Pan-Robotics/DRV8243-LS7366R-Motion-Controller/README.md

# DRV8243-LS7366R-Motion-Controller
Motion Control PCB, integrating the DRV8243 motor driver and LS7366R encoder reader for feedback control of DC motors
