Pan-Robotics/DRV8243-LS7366R-Motion-Controller/DRV8243 - LS7366R DC Motion Controller/Docs/Photos/3D-Back.png

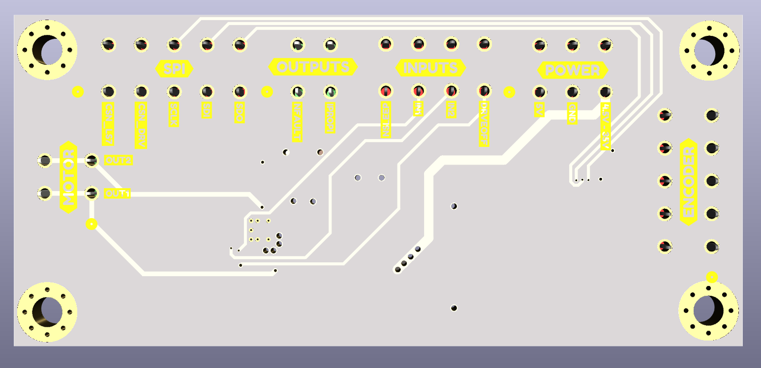
DRV8243 - LS7366R DC Motion Controller/Docs/Photos/3D-Back.png
