Pan-Robotics/DRV8243-LS7366R-Motion-Controller/DRV8243 - LS7366R DC Motion Controller/Docs/DRVLS7 Motion Controller PCB BOM.xls

BOM
Part | Value | Device | Package | Qty | Description | Remark
C1, C3 | 100nF | 1206B104K101CC | C_1206 | 2 | 0.1 µF ±10% 100V Ceramic Capacitor X7R 1206 (3216 Metric) | https://mm.digikey.com/Volume0/opasdata/d220001/medias/docus/5660/3372_1206B104K101CC.pdf
C2 | 100uF | 50TZV100M8X10.5 | C_Elec_8x10.5 | 1 | 100 µF 50 V Aluminum Electrolytic Capacitors Radial, Can - SMD 2000 Hrs @ 105°C | https://www.rubycon.co.jp/wp-content/uploads/catalog-aluminum/TZV.pdf
U1 | DRV8243SQRXYRQ1 | DRV8243SQRXYRQ1 | 14-VQFN-HR (3x4.5) | 1 | Bipolar Motor Driver Bi-CMOS PWM, SPI 14-VQFN-HR (3x4.5) | https://www.ti.com/lit/ds/symlink/drv8243-q1.pdf
J1 | POWER | 1862055 | CONN_1862055 | 1 | TERM BLOCK 3POS 45DEG 3.5MM PCB | https://www.phoenixcontact.com/en-us/products/printed-circuit-board-terminal-sptaf-1-3-35-el-1862055?type=pdf
J2 | CNTRL_IN | 1862068 | CONN_1862068 | 1 | TERM BLOCK 4POS 45DEG 3.5MM PCB | https://www.phoenixcontact.com/en-us/products/printed-circuit-board-terminal-sptaf-1-4-35-el-1862068?type=pdf
J3 | CNTRL_OUT | 1862042 | CONN_1862042 | 1 | TERM BLOCK 2POS 45DEG 3.5MM PCB | https://www.phoenixcontact.com/product/pdf/api/v1/MTg2MjA0Mg?_realm=us&_locale=en-US
J4 | SPI | 1862071 | CONN_1862071 | 1 | TERM BLOCK 5POS 45DEG 3.5MM PCB | https://www.phoenixcontact.com/en-us/products/printed-circuit-board-terminal-sptaf-1-5-35-el-1862071?type=pdf
J5 | MOTOR | 1862042 | CONN_1862042 | 1 | TERM BLOCK 2POS 45DEG 3.5MM PCB | https://www.phoenixcontact.com/product/pdf/api/v1/MTg2MjA0Mg?_realm=us&_locale=en-US
J6 | Encoder | 1862071 | CONN_1862071 |  | TERM BLOCK 5POS 45DEG 3.5MM PCB | https://www.phoenixcontact.com/en-us/products/printed-circuit-board-terminal-sptaf-1-5-35-el-1862071?type=pdf
R1 | 5.1K | RMCF1206JT5K10 | R_1206 | 1 | 5.1 kOhms ±5% 0.25W, 1/4W Chip Resistor 1206 (3216 Metric) Automotive AEC-Q200 Thick Film | https://www.seielect.com/catalog/sei-rmcf_rmcp.pdf
U2 | LS7366R-TS | LS7366R-TS | 14-TSSOP | 1 | Counter IC Binary Counter 1 Element 32 Bit Positive, Negative 14-TSSOP | https://lsicsi.com/wp-content/uploads/2021/06/LS7366R.pdf
CR1 | AS-40.000-18-F-EXT-SMD-TR | AS-40.000-18-F-EXT-SMD-TR |  | 1 | CRYSTAL 40.0000MHZ 18PF SMD | https://www.raltron.com/webproducts/specs/CRYSTAL/AS-40.000-18-F-EXT-SMD-TR.pdf
R2 | 10K | RMCF1206FT10K0 | R_1206 | 1 | 10 kOhms ±1% 0.25W, 1/4W Chip Resistor 1206 (3216 Metric) Automotive AEC-Q200 Thick Film | https://www.seielect.com/catalog/sei-rmcf_rmcp.pdf
C4, C5 | 12pF | VJ1206A120KXQCW1BC | C_1206 | 2 | 12 pF ±10% 10V Ceramic Capacitor C0G, NP0 1206 (3216 Metric) | https://www.vishay.com/docs/28548/vjw1bcbascomseries.pdf
