Pan-Robotics/DRV8243-LS7366R-Motion-Controller/DRV8243 - LS7366R DC Motion Controller/AS_40_000_18_F_EXT_SMD_TR/CRYSTAL_RAMI_HC-49S_STD_RAM.step

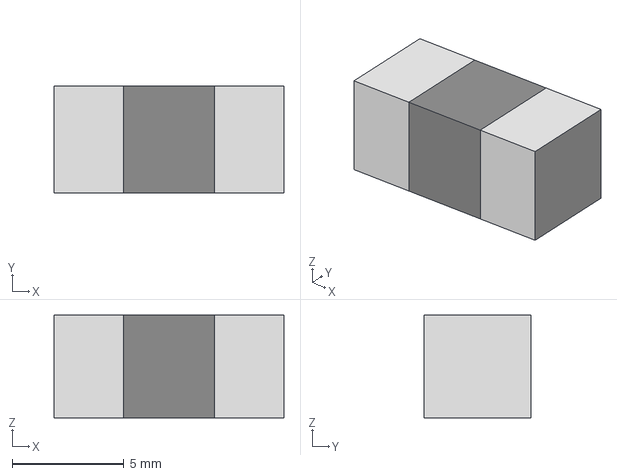
[picture p7: CAD file, 2024-02-08]
DRV8243 - LS7366R DC Motion Controller/AS_40_000_18_F_EXT_SMD_TR/CRYSTAL_RAMI_HC-49S_STD_RAM.step
10.3 x 4.80 x 4.60 mm
