Pan-Robotics/DRV8243-LS7366R-Motion-Controller/DRV8243 - LS7366R DC Motion Controller/DRV8243SQRXYRQ1/RXY0014A.stp

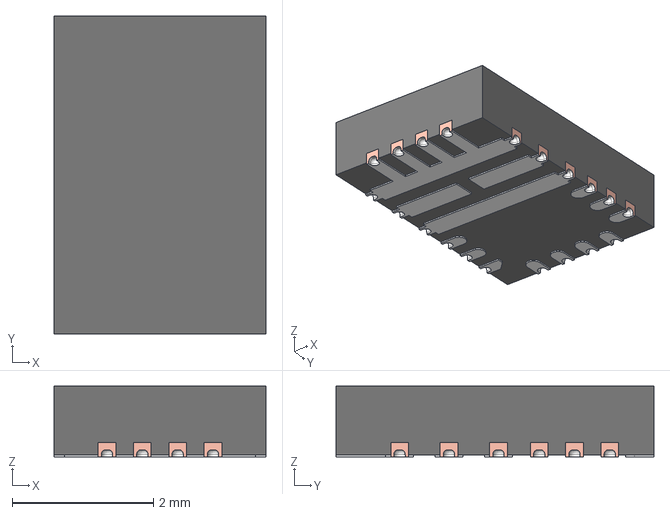
[picture p8: CAD file, 2024-02-08]
DRV8243 - LS7366R DC Motion Controller/DRV8243SQRXYRQ1/RXY0014A.stp
3.00 x 4.50 x 1.00 mm
FRAME
MOLD
