Pan-Robotics/DRV8243-LS7366R-Motion-Controller/DRV8243 - LS7366R DC Motion Controller/LS7366R_TS/LS7366R-TS.step

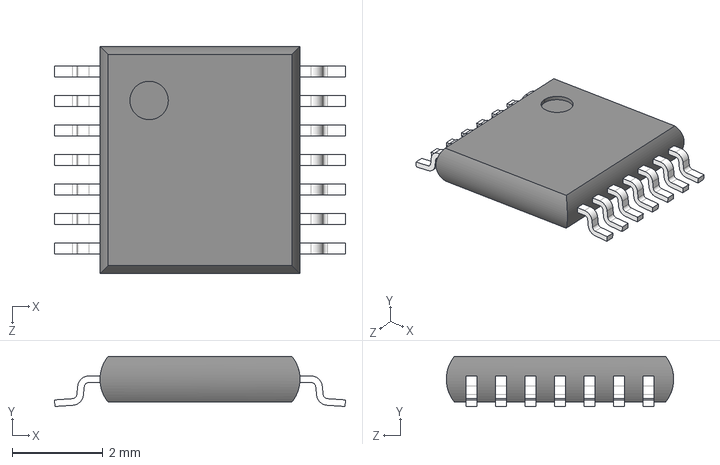
[picture p9: CAD file, 2024-02-08]
DRV8243 - LS7366R DC Motion Controller/LS7366R_TS/LS7366R-TS.step
6.40 x 1.10 x 5.00 mm
