Pan-Robotics/DRV8243-LS7366R-Motion-Controller/DRV8243 - LS7366R DC Motion Controller/1862042/1862042.step

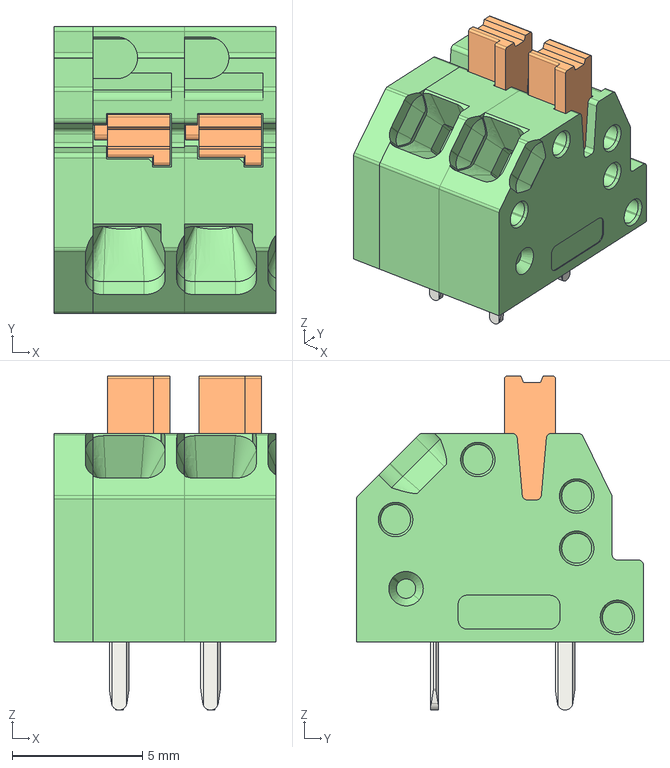
[picture p10: CAD file, 2024-02-08]
DRV8243 - LS7366R DC Motion Controller/1862042/1862042.step
8.50 x 11.0 x 12.8 mm
