Pan-Robotics/DRV8243-LS7366R-Motion-Controller/DRV8243 - LS7366R DC Motion Controller/1862055/1862055.stp

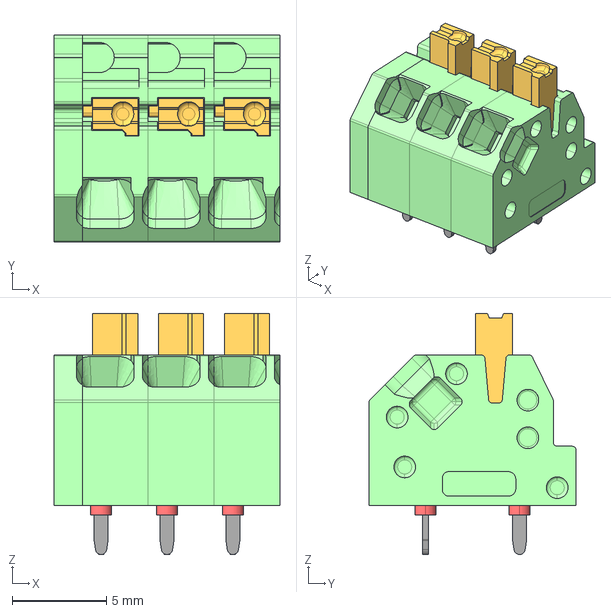
[picture p11: CAD file, 2024-02-08]
DRV8243 - LS7366R DC Motion Controller/1862055/1862055.stp
12.0 x 11.0 x 12.8 mm
