Pan-Robotics/DRV8243-LS7366R-Motion-Controller/DRV8243 - LS7366R DC Motion Controller/1862071/1862071.STEP

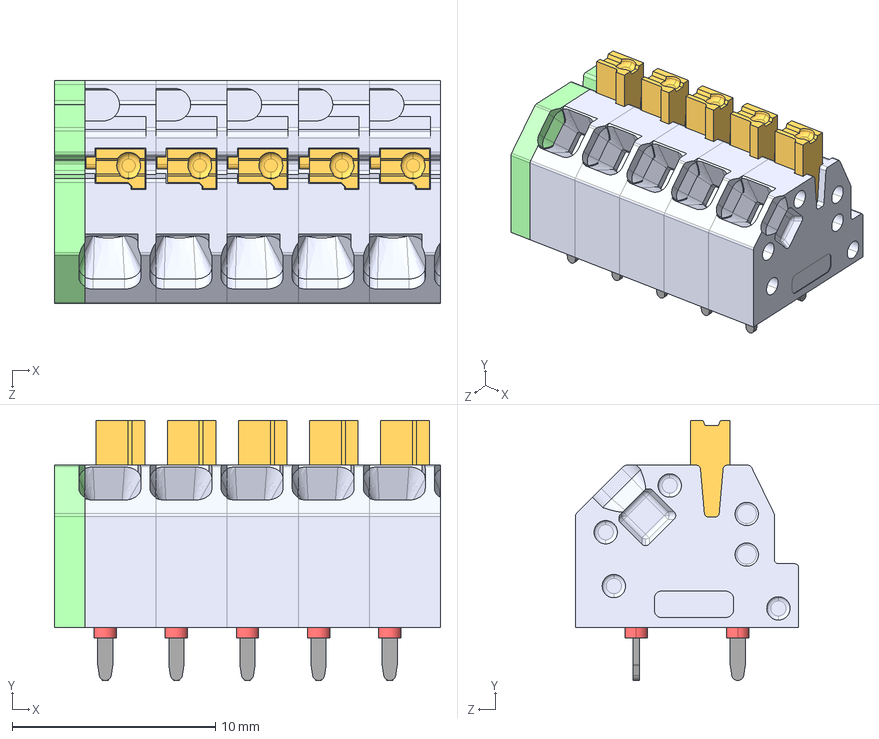
[picture p12: CAD file, 2024-02-08]
DRV8243 - LS7366R DC Motion Controller/1862071/1862071.STEP
19.0 x 12.8 x 11.0 mm
Bohrloch.2.stp x 5
Bohrloch.1.1.stp x 5
SPTAF_1-3.5_housing.stp x 5
SPTAF-0-DKL.1.stp
