Pan-Robotics/DRV8243-LS7366R-Motion-Controller/DRV8243 - LS7366R DC Motion Controller/LIB_1862068/1862068/3D/1862068.stp

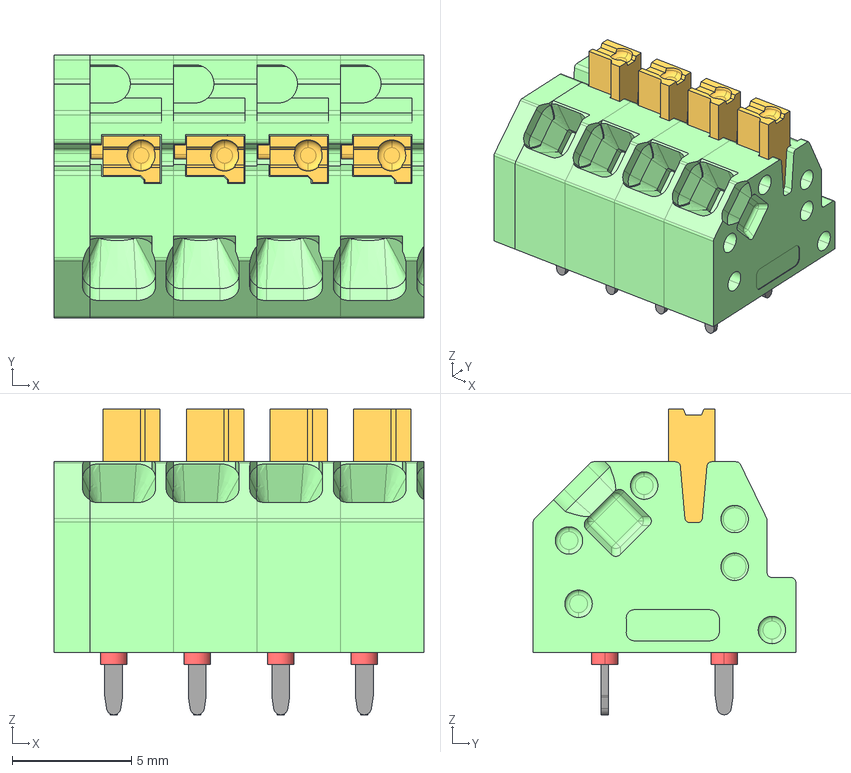
[picture p13: CAD file, 2024-02-08]
DRV8243 - LS7366R DC Motion Controller/LIB_1862068/1862068/3D/1862068.stp
15.5 x 11.0 x 12.8 mm
Bohrloch.1.1 x 4
Bohrloch.2 x 4
SPTAF_1-3.5_housing x 4
SPTAF-0-DKL.1
