Pan-Robotics/DRV8243-LS7366R-Motion-Controller/DRV8243 - LS7366R DC Motion Controller/LIB_1862262/1862262/3D/1862262.stp

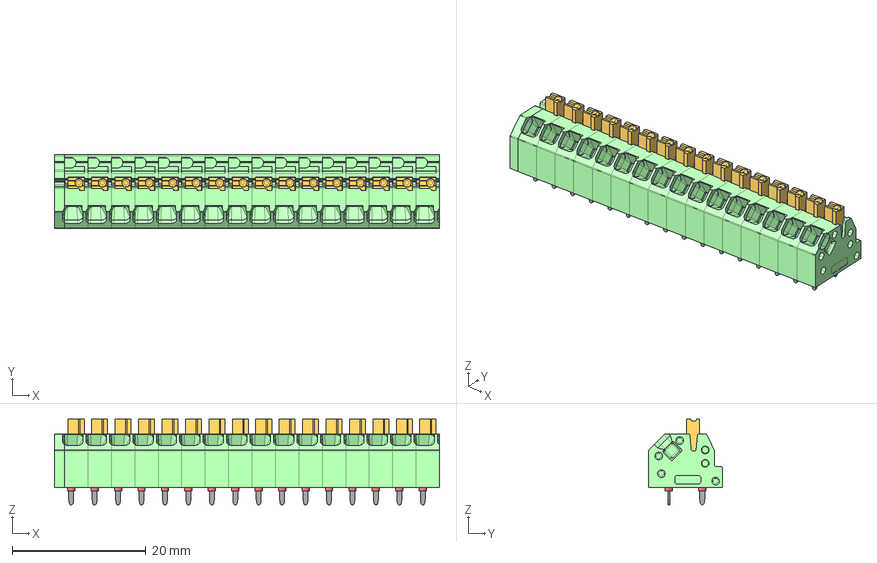
[picture p14: CAD file, 2024-02-08]
DRV8243 - LS7366R DC Motion Controller/LIB_1862262/1862262/3D/1862262.stp
57.5 x 11.0 x 12.8 mm
Bohrloch.1.1.2 x 16
Bohrloch.2.2 x 16
SPTAF_1-3.5_housing.13 x 16
SPTAF-0-DKL.1
