Pan-Robotics/DRV8243-LS7366R-Motion-Controller/(list of files, cad)

Other CAD files:
DRV8243 - LS7366R DC Motion Controller/DRV8243SQRXYRQ1/RXY0014A.stl
DRV8243 - LS7366R DC Motion Controller/LIB_1862068/1862068/Allegro/1862068.psm
DRV8243 - LS7366R DC Motion Controller/LIB_1862068/1862068/DEHDL/1862068/chips/chips.prt
