Pan-Robotics/DRV8243-LS7366R-Motion-Controller/DRV8243 - LS7366R DC Motion Controller/Docs/DRV8243 - LS7366R DC Motion Controller.pdf

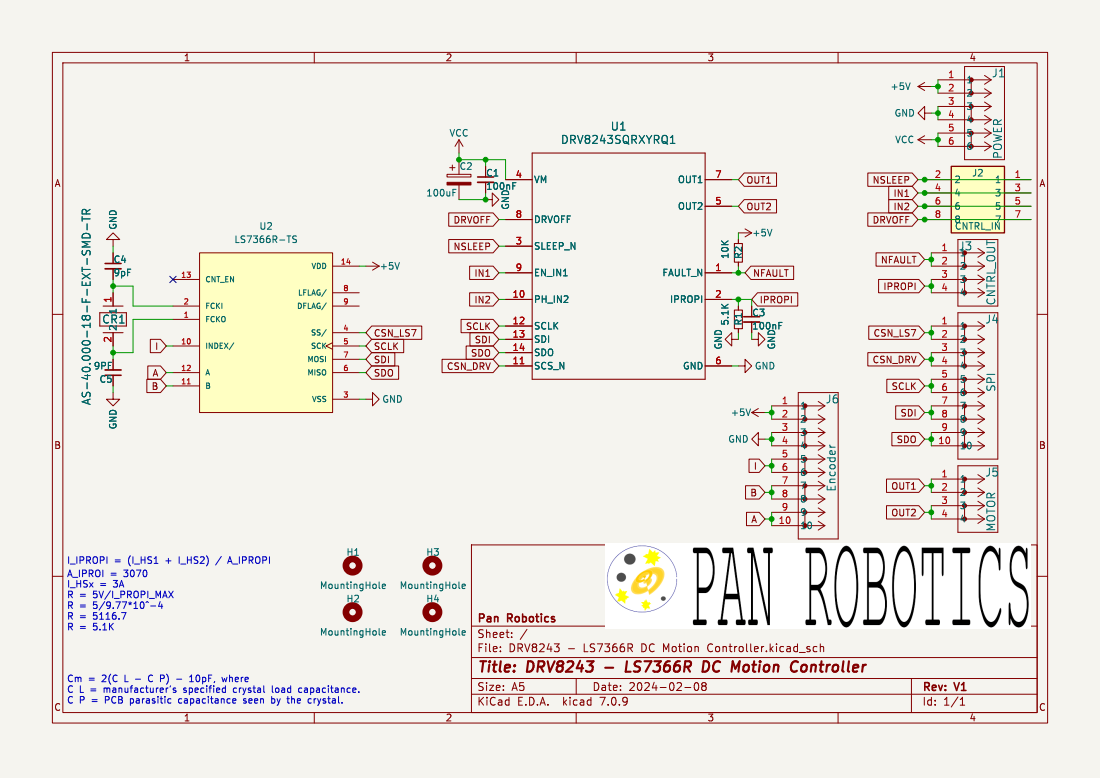
[picture p15: page 1]

Sheet: /
Title: DRV8243 - LS7366R DC Motion Controller
