Pan-Robotics/DRV8243-LS7366R-Motion-Controller/(list of files, drawings)

Other design files:
DRV8243 - LS7366R DC Motion Controller/LIB_1862068/1862068/Altium/1862068.PcbLib
DRV8243 - LS7366R DC Motion Controller/LIB_1862068/1862068/Altium/1862068.SchLib
