Pan-Robotics/DRV8243-LS7366R-Motion-Controller/DRV8243 - LS7366R DC Motion Controller/DRV8243 - LS7366R DC Motion Controller/DRV8243 - LS7366R DC Motion Controller.kicad_pcb

## KiCad design DRV8243 - LS7366R DC Motion Controller/DRV8243 - LS7366R DC Motion Controller/DRV8243 - LS7366R DC Motion Controller.kicad_pcb (2024-02-08)

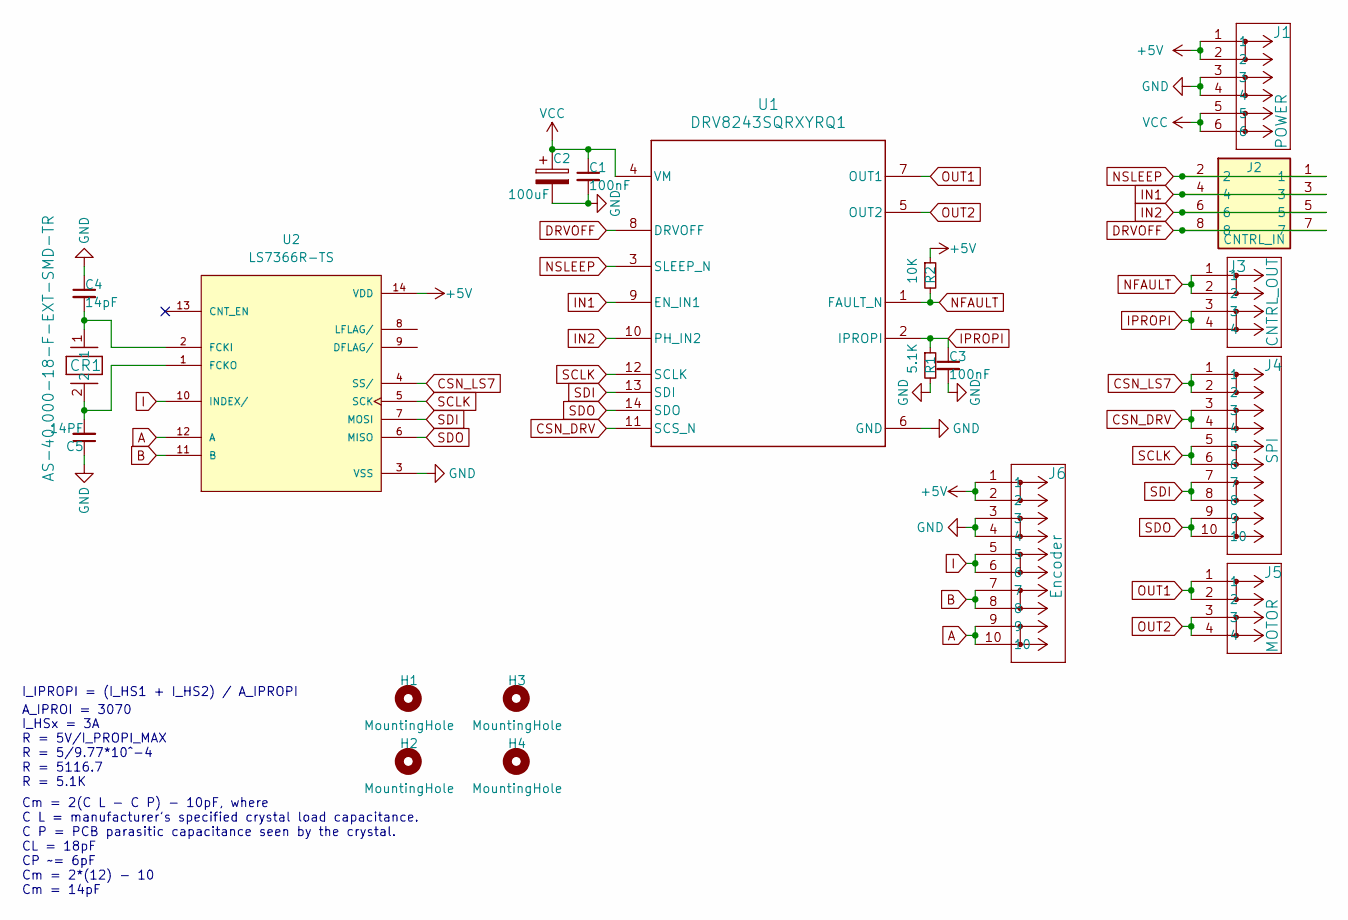
[picture p16: schematic DRV8243 - LS7366R DC Motion Controller.kicad_sch]

Parts:
C1, C3: 100nF; C_1206_3216Metric_Pad1.33x1.80mm_HandSolder
C2: 100uF; C_Elec_8x10.2
C4: 14pF; C_1206_3216Metric_Pad1.33x1.80mm_HandSolder
C5: 14PF; C_1206_3216Metric_Pad1.33x1.80mm_HandSolder
CR1: AS-40.000-18-F-EXT-SMD-TR; CRYSTAL_RAMI_HC-49&slash_S_STD_RAM
H1, H2, H3, H4: MountingHole; MountingHole_3.2mm_M3_Pad_Via
J1: POWER; CONN_1862055
J2: CNTRL_IN; 1862068; Mouser Part Number 651-1862068
J3: CNTRL_OUT; CONN_1862042
J4: SPI; CONN_1862071
J5: MOTOR; CONN_1862042
J6: Encoder; CONN_1862071
R1: 5.1K; R_1206_3216Metric_Pad1.30x1.75mm_HandSolder
R2: 10K; R_1206_3216Metric_Pad1.30x1.75mm_HandSolder
U1: DRV8243SQRXYRQ1; RXY0014A-MFG
U2: LS7366R-TS; SOP65P640X120-14N; PARTREV June 2014

Connections:
+5V: J1.1, J1.2, J6.1, J6.2, R2.1, U2.14 (VDD)
A: J6.9, J6.10, U2.12 (A)
B: J6.7, J6.8, U2.11 (B)
CSN_DRV: J4.3, J4.4, U1.11 (SCS_N)
CSN_LS7: J4.1, J4.2, U2.4 (SS/)
DRVOFF: J2.7, J2.8, U1.8 (DRVOFF)
GND: C1.2, C2.2, C3.2, C4.1, C5.1, J1.3, J1.4, J6.3, J6.4, R1.2, U1.6 (GND), U2.3 (VSS)
I: J6.5, J6.6, U2.10 (INDEX/)
IN1: J2.3, J2.4, U1.9 (EN_IN1)
IN2: J2.5, J2.6, U1.10 (PH_IN2)
IPROPI: C3.1, J3.3, J3.4, R1.1, U1.2 (IPROPI)
NFAULT: J3.1, J3.2, R2.2, U1.1 (FAULT_N)
NSLEEP: J2.1, J2.2, U1.3 (SLEEP_N)
unnamed: C4.2, CR1.1, U2.2 (FCKI)
unnamed: C5.2, CR1.2, U2.1 (FCKO)
OUT1: J5.1, J5.2, U1.7 (OUT1)
OUT2: J5.3, J5.4, U1.5 (OUT2)
SCLK: J4.5, J4.6, U1.12 (SCLK), U2.5 (SCK)
SDI: J4.7, J4.8, U1.13 (SDI), U2.7 (MOSI)
SDO: J4.9, J4.10, U1.14 (SDO), U2.6 (MISO)
VCC: C1.1, C2.1, J1.5, J1.6, U1.4 (VM)

Notes on the sheet:
I_HSx = 3A R = 5V/I_PROPI_MAX R = 5/9.77*10^-4 R = 5116.7 R = 5.1K
A_IPROI = 3070
Cm = 2(C L - C P) - 10pF, where C L = manufacturer's specified crystal load capacitance. C P = PCB parasitic capacitance seen by the crystal. CL = 18pF CP ~= 6pF Cm = 2*(12) - 10 Cm = 14pF
I_IPROPI = (I_HS1 + I_HS2) / A_IPROPI

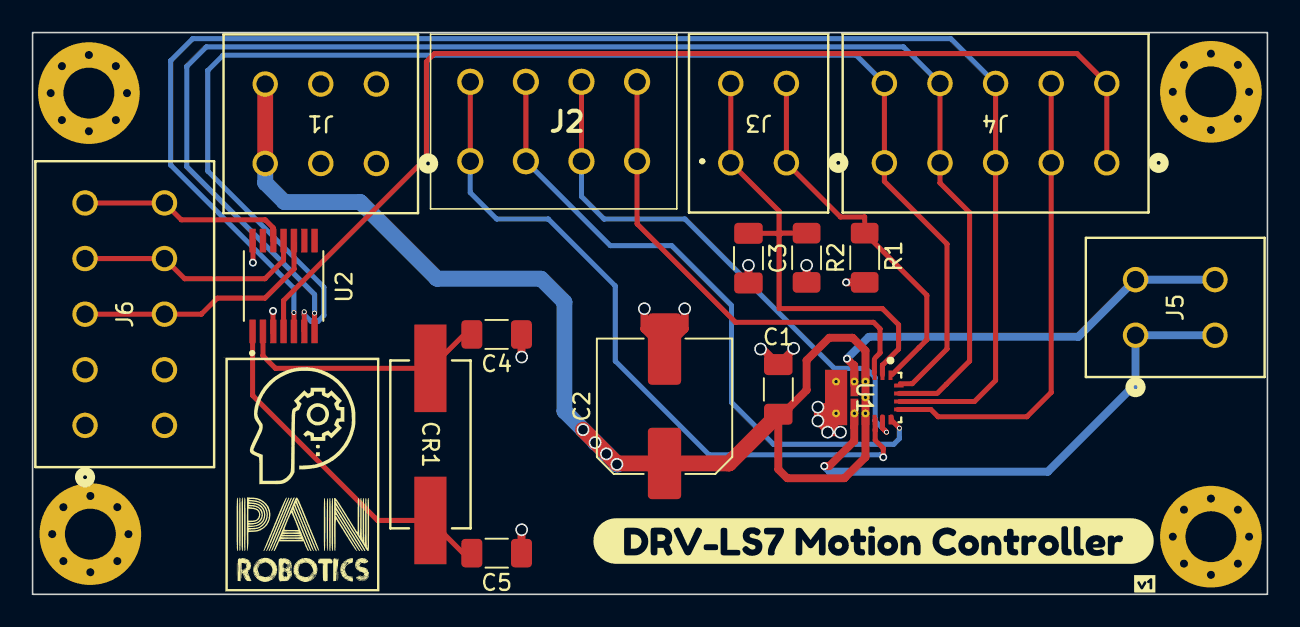
[picture p17: board DRV8243 - LS7366R DC Motion Controller.kicad_pcb from above]

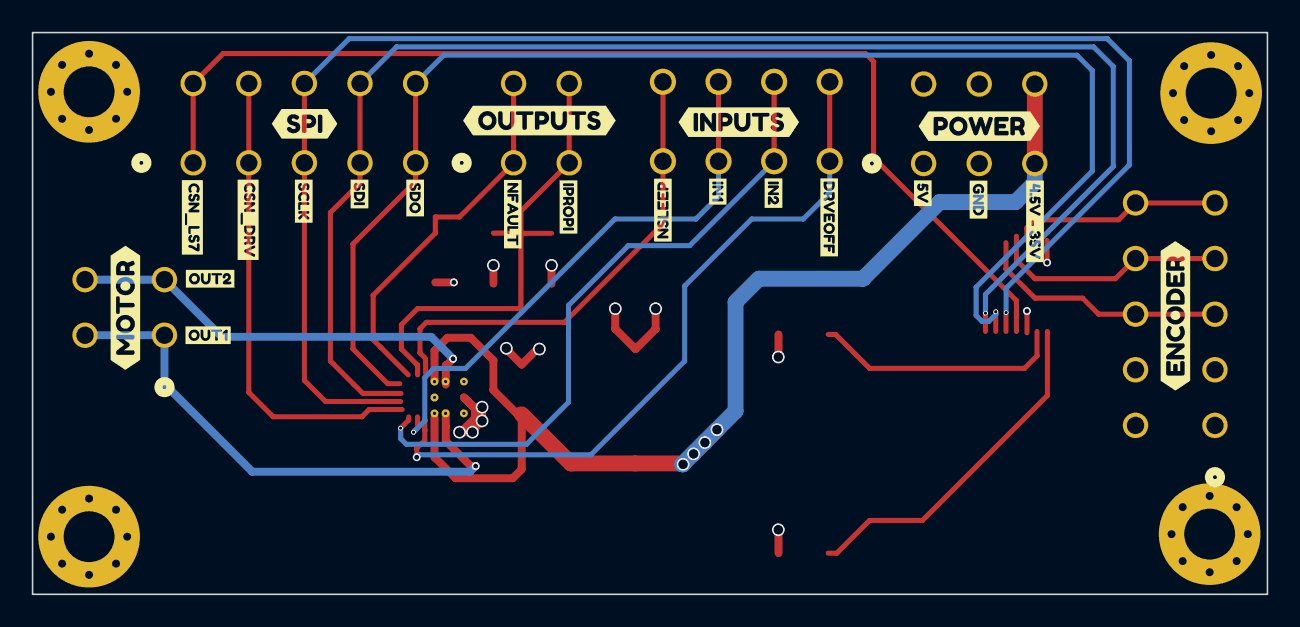
[picture p18: board DRV8243 - LS7366R DC Motion Controller.kicad_pcb from below]

Board: 4 copper layers, 77.7 x 35.4 mm, 44 parts (22 on the bottom side), 21 nets.

Other parts of the board:
kibuzzard-65A6FC0C: G***; kibuzzard-65A6FC0C
kibuzzard-65A6FCAC: G***; kibuzzard-65A6FCAC
kibuzzard-65A6FCCE: G***; kibuzzard-65A6FCCE
kibuzzard-65A6FCD9: G***; kibuzzard-65A6FCD9
kibuzzard-65A6FCE2: G***; kibuzzard-65A6FCE2
kibuzzard-65A6FD3E: G***; kibuzzard-65A6FD3E
kibuzzard-65A6FD04: G***; kibuzzard-65A6FD04
kibuzzard-65A6FD36: G***; kibuzzard-65A6FD36
kibuzzard-65A6FFF9: G***; kibuzzard-65A6FFF9
kibuzzard-65A7000E: G***; kibuzzard-65A7000E
kibuzzard-65A7001B: G***; kibuzzard-65A7001B
kibuzzard-65A7039D: G***; kibuzzard-65A7039D
kibuzzard-65A70003: G***; kibuzzard-65A70003
kibuzzard-65BE5B8E: G***; kibuzzard-65BE5B8E
kibuzzard-65BE5B66: G***; kibuzzard-65BE5B66
kibuzzard-65BE5BEC: G***; kibuzzard-65BE5BEC
kibuzzard-65BE5BF3: G***; kibuzzard-65BE5BF3
kibuzzard-65BE5BFB: G***; kibuzzard-65BE5BFB
kibuzzard-65BE5C3B: G***; kibuzzard-65BE5C3B
kibuzzard-65C4F8D9: G***; kibuzzard-65C4F8D9
kibuzzard-65C4F8EC: G***; kibuzzard-65C4F8EC
kibuzzard-65C4F282: G***; kibuzzard-65C4F282
kibuzzard-65C4F368: G***; kibuzzard-65C4F368
kibuzzard-65C504A9: G***; kibuzzard-65C504A9
